ynaik16/Industrial-Gas-Monitor/README.md

# Industrial-Gas-Monitor
An ASIC design for tracking gas levels between two industrial grade gas sensors, within a specific range.
