ynaik16/Industrial-Gas-Monitor/revD.brd

## EAGLE design revD.brd (2019-06-01)

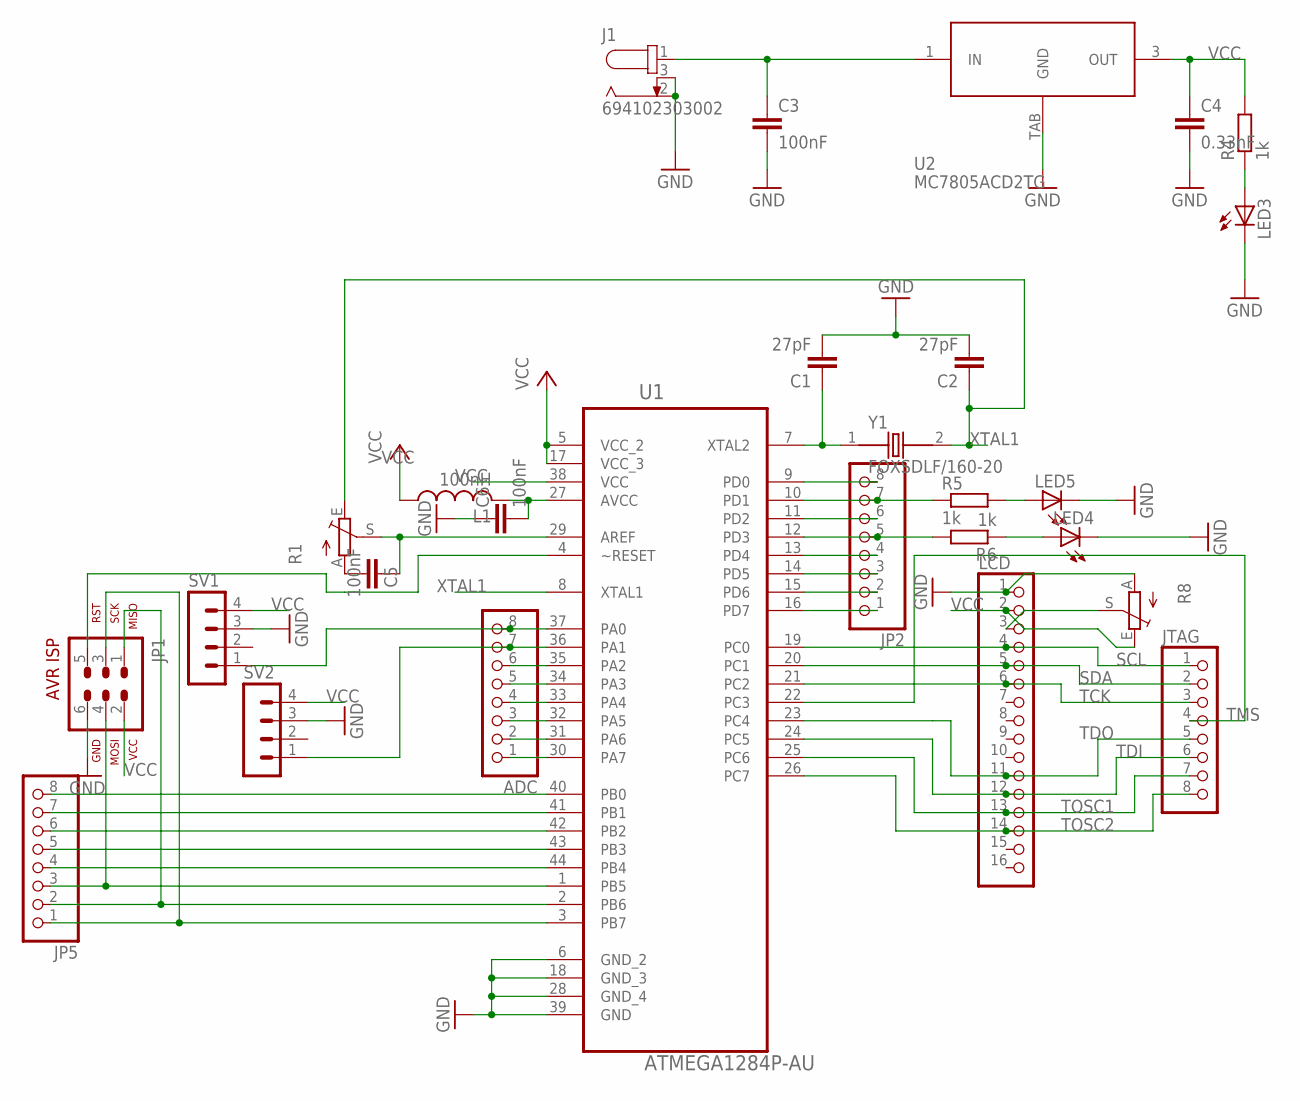
[picture p1: schematic revD.sch, sheet 1]

Parts:
ADC: PINHD-1X8; 1X08
C1, C2: 27pF; C1206
C3, C5, C6: 100nF; C1206
C4: 0.33nF; C1206
J1: 694102303002; 69410X303002
JP1: AVR-ISP-6VERT; AVR-ISP-6
JP2, JP5: PINHD-1X8; 1X08
JTAG: PINHD-1X8; 1X08
L1: 100nH; L1812
LCD: PINHD-1X16; 1X16
LED3, LED4, LED5: LED3MM
R1, R8: TRIM_1234-S64YW; S64YW
R4, R5, R6: 1k; M1206
SV1, SV2: MA04-1
U1: ATMEGA1284P-AU; QFP80P1200X1200X120-44N
U2: MC7805ACD2TG; D2PAK
Y1: FOXSDLF/160-20; XTAL_FOXSDLF/160-20

Connections:
GND: C1.2, C2.2, C3.2, C4.2, C6.1, J1.2, J1.3, JP1.6, LCD.1, LED3.K (C), LED4.K (C), LED5.K (C), R8.A, SV1.3, SV2.3, U1.6 (GND_2), U1.18 (GND_3), U1.28 (GND_4), U1.39 (GND), U2.TAB (GND); also elsewhere on the board
unnamed: C1.1, U1.7 (XTAL2), Y1.1
unnamed: C5.1, R1.S, U1.29 (AREF)
unnamed: C5.2, R1.A
unnamed: C6.2, L1.2, U1.27 (AVCC)
unnamed: C3.1, J1.1, U2.1 (IN)
unnamed: LED3.A, R4.1
unnamed: LED4.A, R6.1
unnamed: LED5.A, R5.2
unnamed: LCD.3, R8.S
unnamed: JP5.8, U1.40 (PB0)
unnamed: JP5.7, U1.41 (PB1)
unnamed: JP5.6, U1.42 (PB2)
unnamed: JP5.5, U1.43 (PB3)
unnamed: JP5.4, U1.44 (PB4)
unnamed: JP1.4, JP5.3, U1.1 (PB5)
unnamed: JP1.1, JP5.2, U1.2 (PB6)
unnamed: JP1.3, JP5.1, U1.3 (PB7)
unnamed: ADC.8, SV1.1, U1.37 (PA0)
unnamed: ADC.7, SV2.1, U1.36 (PA1)
unnamed: ADC.6, U1.35 (PA2)
unnamed: ADC.5, U1.34 (PA3)
unnamed: ADC.4, U1.33 (PA4)
unnamed: ADC.3, U1.32 (PA5)
unnamed: ADC.2, U1.31 (PA6)
unnamed: ADC.1, U1.30 (PA7)
unnamed: JP2.8, U1.9 (PD0)
unnamed: JP2.7, R5.1, U1.10 (PD1)
unnamed: JP2.6, U1.11 (PD2)
unnamed: JP2.5, R6.2, U1.12 (PD3)
unnamed: JP2.4, U1.13 (PD4)
unnamed: JP2.3, U1.14 (PD5)
unnamed: JP2.2, U1.15 (PD6)
unnamed: JP2.1, U1.16 (PD7)
unnamed: JP1.5, U1.4 (~RESET)
SCL: JTAG.1, LCD.4, U1.19 (PC0)
SDA: JTAG.2, LCD.5, U1.20 (PC1)
TCK: JTAG.3, LCD.6, U1.21 (PC2)
TDI: JTAG.6, LCD.12, U1.24 (PC5)
TDO: JTAG.5, LCD.11, U1.23 (PC4)
TMS: JTAG.4, U1.22 (PC3)
TOSC1: JTAG.7, LCD.13, U1.25 (PC6)
TOSC2: JTAG.8, LCD.14, U1.26 (PC7)
VCC: C4.1, JP1.2, L1.1, LCD.2, R4.2, R8.E, SV1.4, SV2.4, U1.5 (VCC_2), U1.17 (VCC_3), U1.38 (VCC), U2.3 (OUT); also elsewhere on the board
XTAL1: C2.1, R1.E, U1.8 (XTAL1), Y1.2

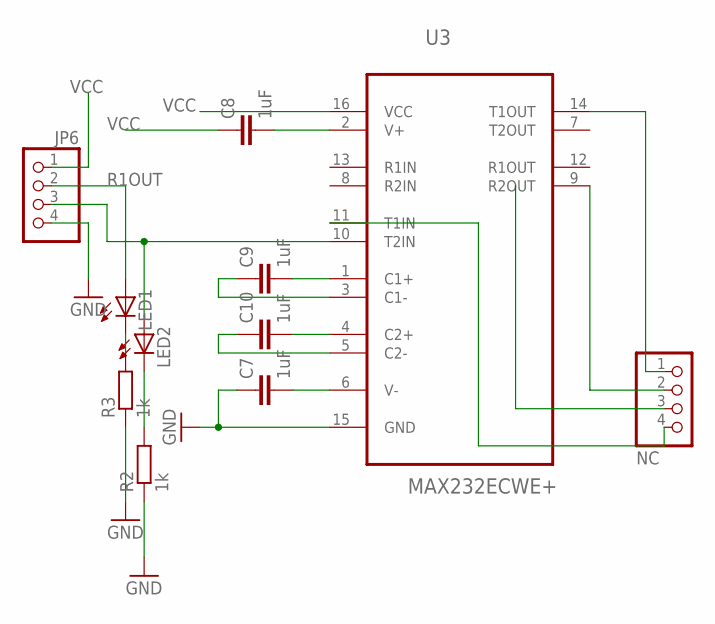
[picture p2: schematic revD.sch, sheet 2]

Parts:
C7, C8, C9, C10: 1uF; C1206
JP6: PINHD-1X4; 1X04
LED1, LED2: LEDSMT1206; 1206
NC: NC; 1X04
R2, R3: 1k; R1206
U3: MAX232ECWE+; SOIC127P1032X265-16N

Connections:
GND: C7.1, JP6.4, R2.1, R3.1, U3.15 (GND); also elsewhere on the board
unnamed: C8.2, U3.2 (V+)
unnamed: C7.2, U3.6 (V-)
unnamed: C10.2, U3.4 (C2+)
unnamed: C10.1, U3.5 (C2-)
unnamed: C9.2, U3.1 (C1+)
unnamed: C9.1, U3.3 (C1-)
unnamed: JP6.3, LED2.A, U3.10 (T2IN)
unnamed: LED1.C, R3.2
unnamed: LED2.C, R2.2
unnamed: NC.1, U3.14 (T1OUT)
unnamed: NC.2, U3.9 (R2OUT)
unnamed: NC.4, U3.11 (T1IN)
R1OUT: JP6.2, LED1.A
VCC: C8.1, JP6.1, U3.16 (VCC); also elsewhere on the board

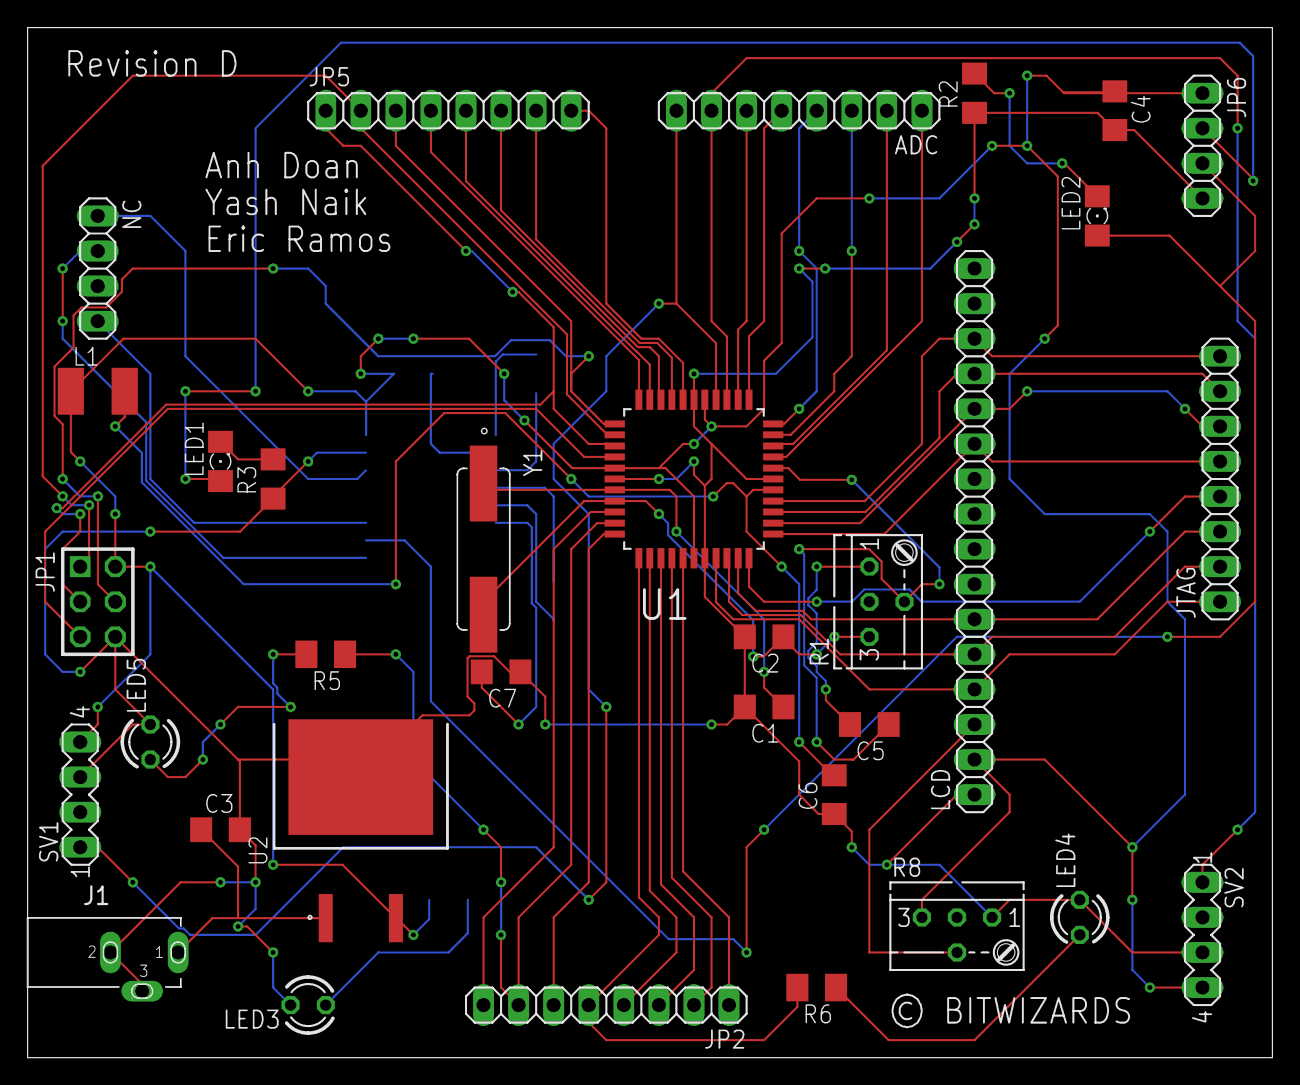
[picture p3: board revD.brd from above]

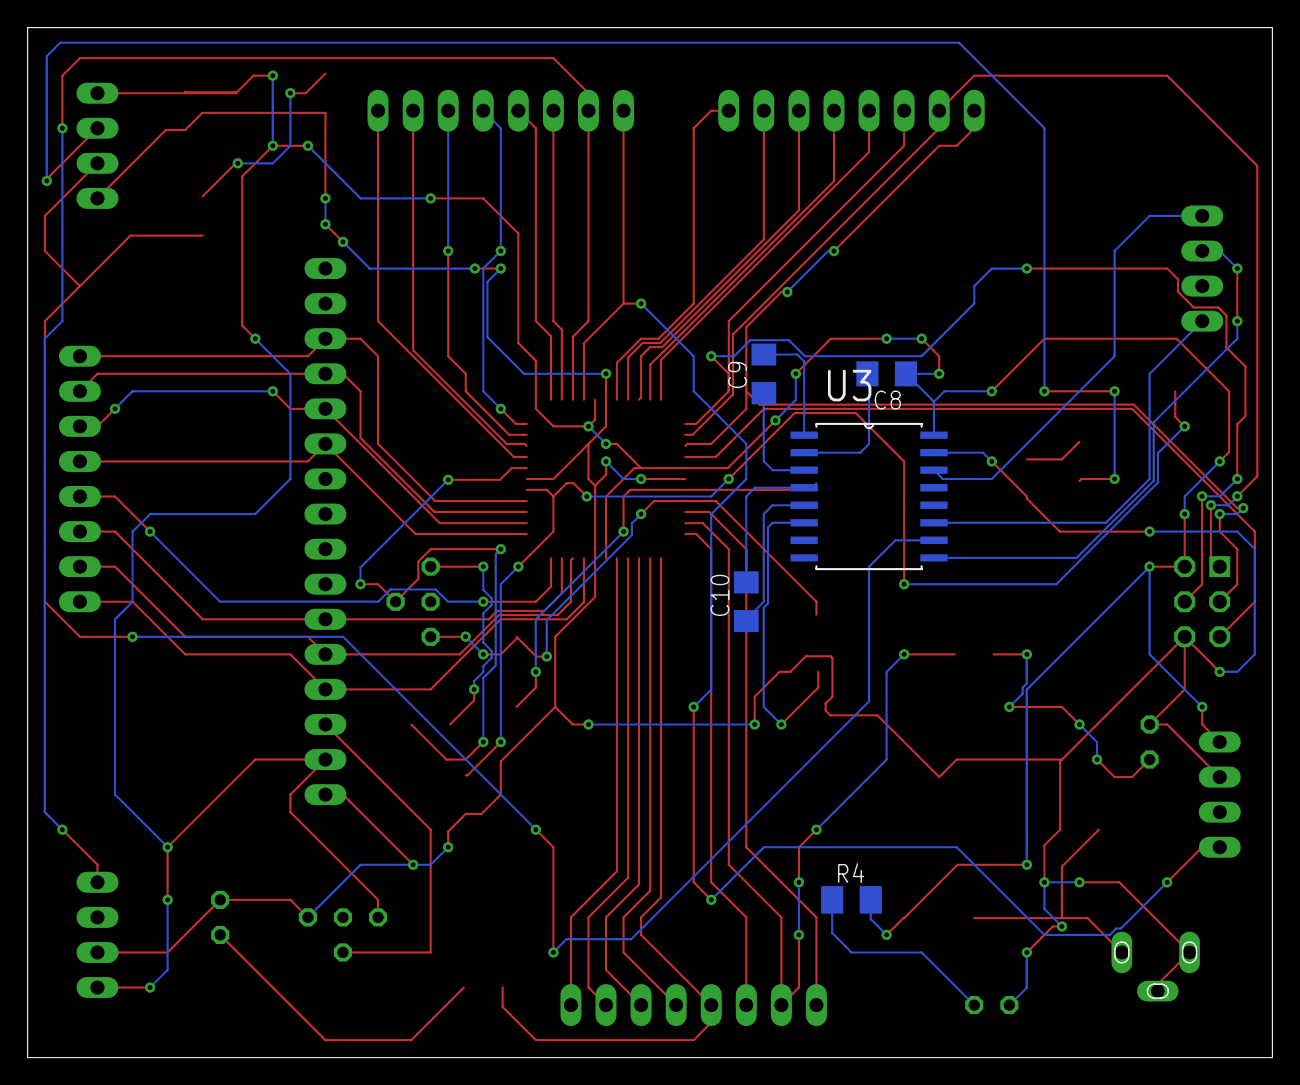
[picture p4: board revD.brd from below]

Board: 2 copper layers, 90.2 x 74.6 mm, 38 parts (5 on the bottom side), 58 nets.
