ynaik16/Industrial-Gas-Monitor/(notices)

Notices in the files:
revD.brd:
© BITWIZARDS
